WA2T/Hermes-Lite2/MicJackFixWires.jpeg

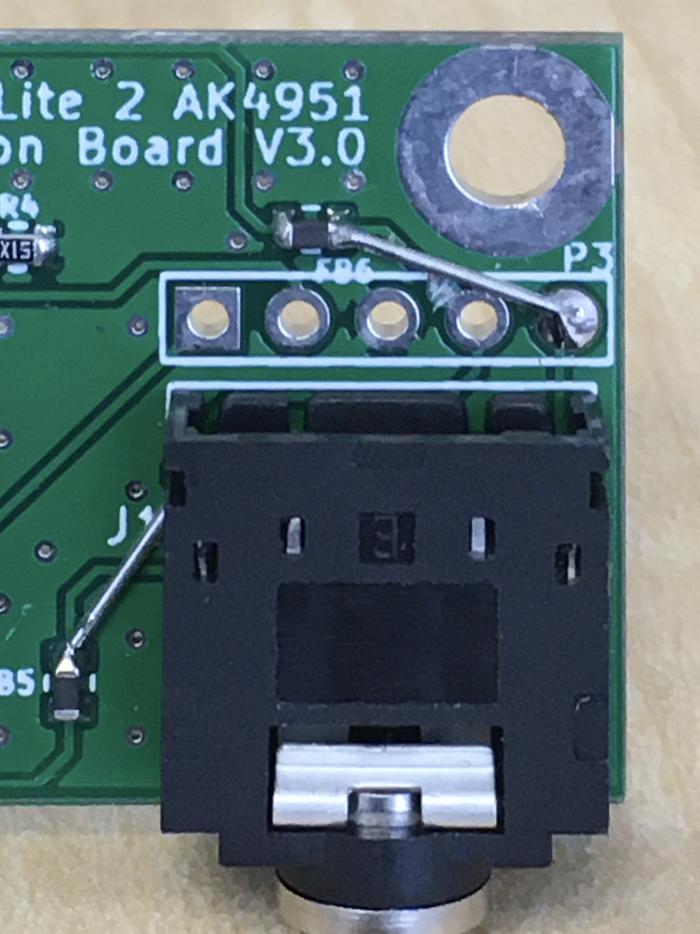
MicJackFixWires.jpeg
