WA2T/Hermes-Lite2/MicJackFixPCB.jpeg

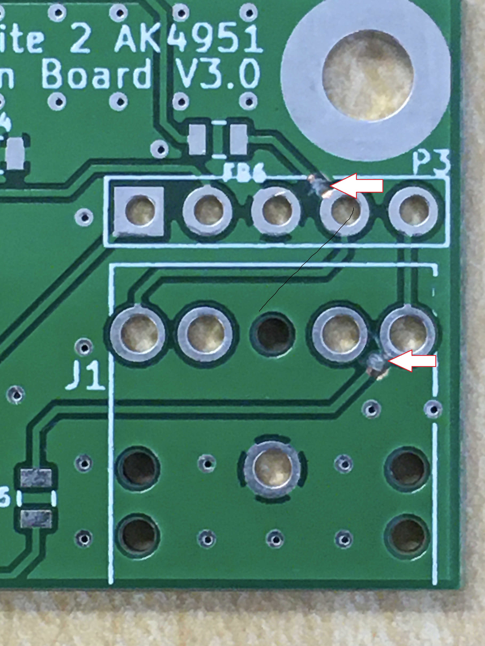
MicJackFixPCB.jpeg
