WA2T/Hermes-Lite2/CompBd1.jpeg

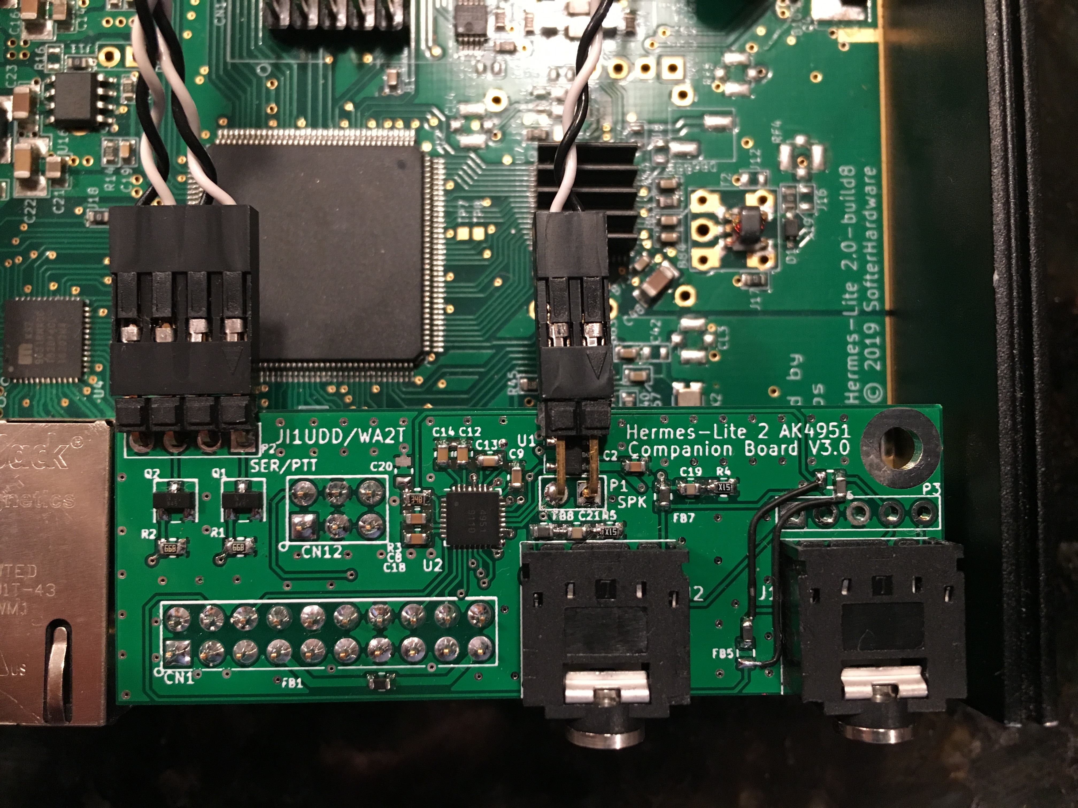
CompBd1.jpeg
