WA2T/Hermes-Lite2/CompBdMicJackMod.jpeg

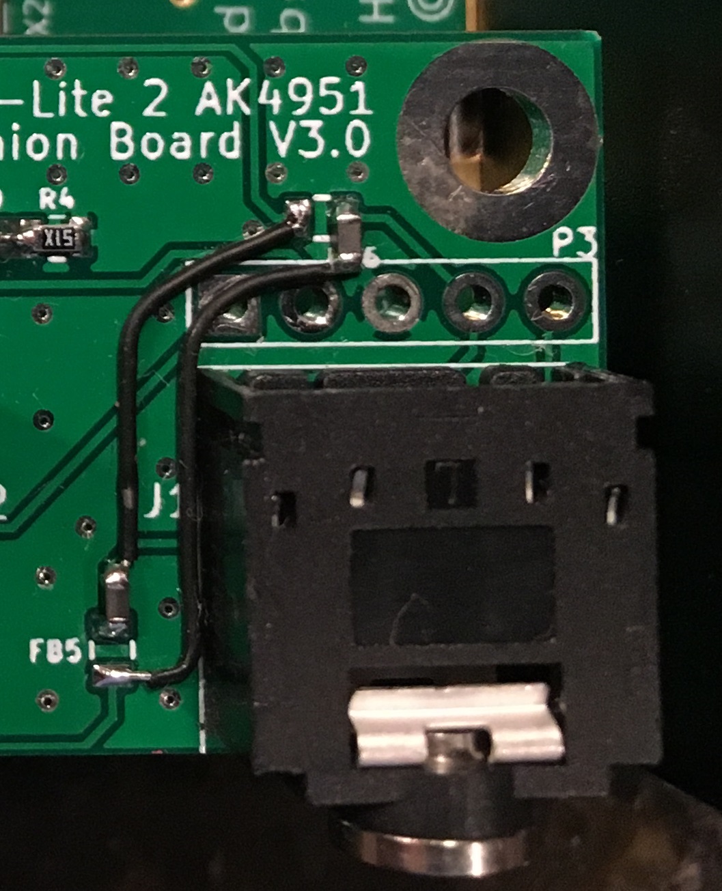
CompBdMicJackMod.jpeg
