WA2T/Hermes-Lite2/CompBoardV3Sch.jpg

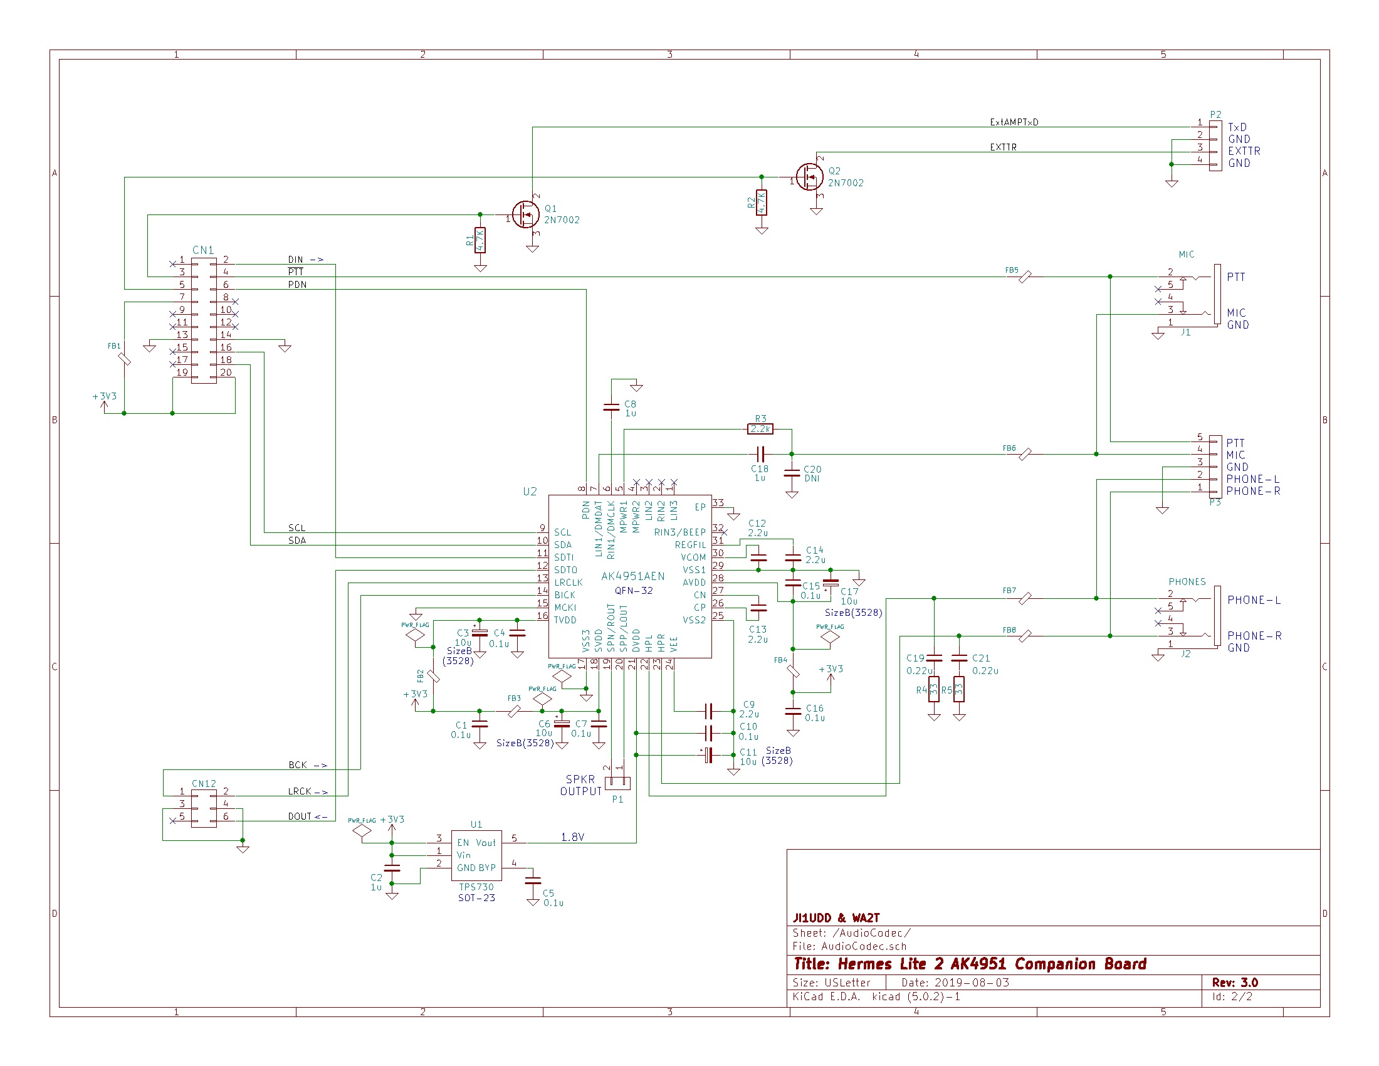
CompBoardV3Sch.jpg
