WA2T/Hermes-Lite2/HL2_Companion_V3.jpg

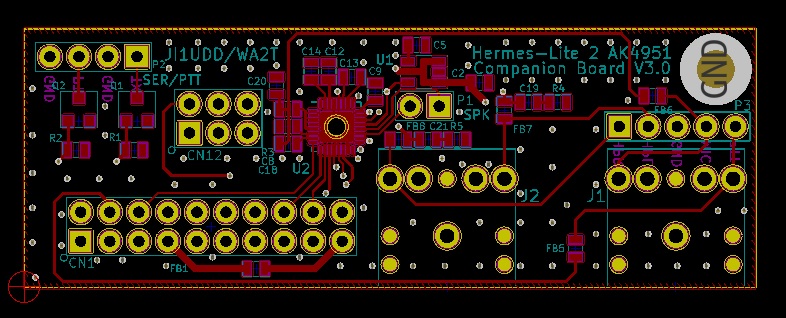
HL2_Companion_V3.jpg
