WA2T/Hermes-Lite2/PJ-307.jpg

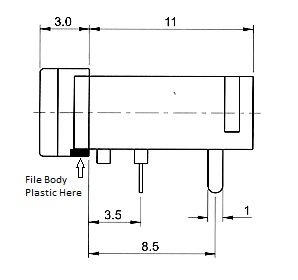
PJ-307.jpg
