WA2T/Hermes-Lite2/Digikey Cart.xlsx

Index | Quantity | Part Number | Manufacturer Part Number | Description | Customer Reference | Available | Backorder | Unit Price | Extended Price USD
1 | 3 | 1276-1102-1-ND | CL10A105KA8NNNC | CAP CER 1UF 25V X5R 0603 |  | 3 | 0 | 0.1 | 0.30
2 | 4 | 490-12738-1-ND | GRM188R61E225MA12D | CAP CER 2.2UF 25V X5R 0603 |  | 4 | 0 | 0.15 | 0.60
3 | 8 | 445-2205-1-ND | MPZ1608S601ATA00 | FERRITE BEAD 600 OHM 0603 1LN |  | 8 | 0 | 0.1 | 0.80
4 | 2 | T2N7002AKLMCT-ND | T2N7002AK,LM | MOSFET N-CH 60V 0.2A |  | 2 | 0 | 0.15 | 0.30
5 | 2 | 1292-1420-1-ND | 0603B224K250CT | CAP CER 0.22UF 25V X7R 0603 |  | 2 | 0 | 0.1 | 0.20
6 | 1 | 296-17577-1-ND | TPS73018DBVT | IC REG LINEAR 1.8V 200MA SOT23-5 |  | 1 | 0 | 0.82 | 0.82
7 | 1 | 974-1064-1-ND | AK4951EN | IC STEREO CODEC 24BIT 32QFN |  | 1 | 0 | 1.79 | 1.79
8 | 2 | CP1-3525N-ND | SJ1-3525N | CONN JACK STEREO 3.5MM R/A |  | 2 | 0 | 0.76 | 1.52
9 | 7 | 1276-CL10B104KB8NNNLCT-ND | CL10B104KB8NNNL | CAP CER 0.1UF 50V X7R 0603 |  | 7 | 0 | 0.1 | 0.70
10 | 2 | 311-4.7KGRCT-ND | RC0603JR-074K7L | RES SMD 4.7K OHM 5% 1/10W 0603 |  | 2 | 0 | 0.1 | 0.20
11 | 2 | 311-33.0HRCT-ND | RC0603FR-0733RL | RES SMD 33 OHM 1% 1/10W 0603 |  | 2 | 0 | 0.1 | 0.20
12 | 1 | 311-2.2KGRCT-ND | RC0603JR-072K2L | RES SMD 2.2K OHM 5% 1/10W 0603 |  | 1 | 0 | 0.1 | 0.10
13 | 4 | 1276-1853-1-ND | CL31F106ZPHNNNE | CAP CER 10UF 10V Y5V 1206 |  | 4 | 0 | 0.19 | 0.76
14 | 1 | S6106-ND | PPPC102LFBN-RC | CONN HDR 20POS 0.1 GOLD PCB |  | 1 | 0 | 1.26 | 1.26
15 | 1 | S7106-ND | PPPC032LFBN-RC | CONN HDR 6POS 0.1 GOLD PCB |  | 1 | 0 | 0.62 | 0.62
16 | 1 | 2057-PH2-20-UA-ND | PH2-20-UA | CONN HEADER VERT 20POS 2.54MM |  | 1 | 0 | 0.28 | 0.28
17 | 1 | 609-3234-ND | 67997-206HLF | CONN HEADER VERT 6POS 2.54MM |  | 1 | 0 | 0.32 | 0.32
18 | 1 | 2057-PH1RB-04-UA-ND | PH1RB-04-UA | CONN HEADER R/A 4POS 2.54MM |  | 1 | 0 | 0.15 | 0.15
19 | 1 | 2057-PH1RA-02-UA-ND | PH1RA-02-UA | CONN HEADER R/A 2POS 2.54MM |  | 1 | 0 | 0.1 | 0.10
