WA2T/Hermes-Lite2/hermeslite.kicad_pcb

## KiCad design hermeslite.kicad_pcb (2019-09-15)

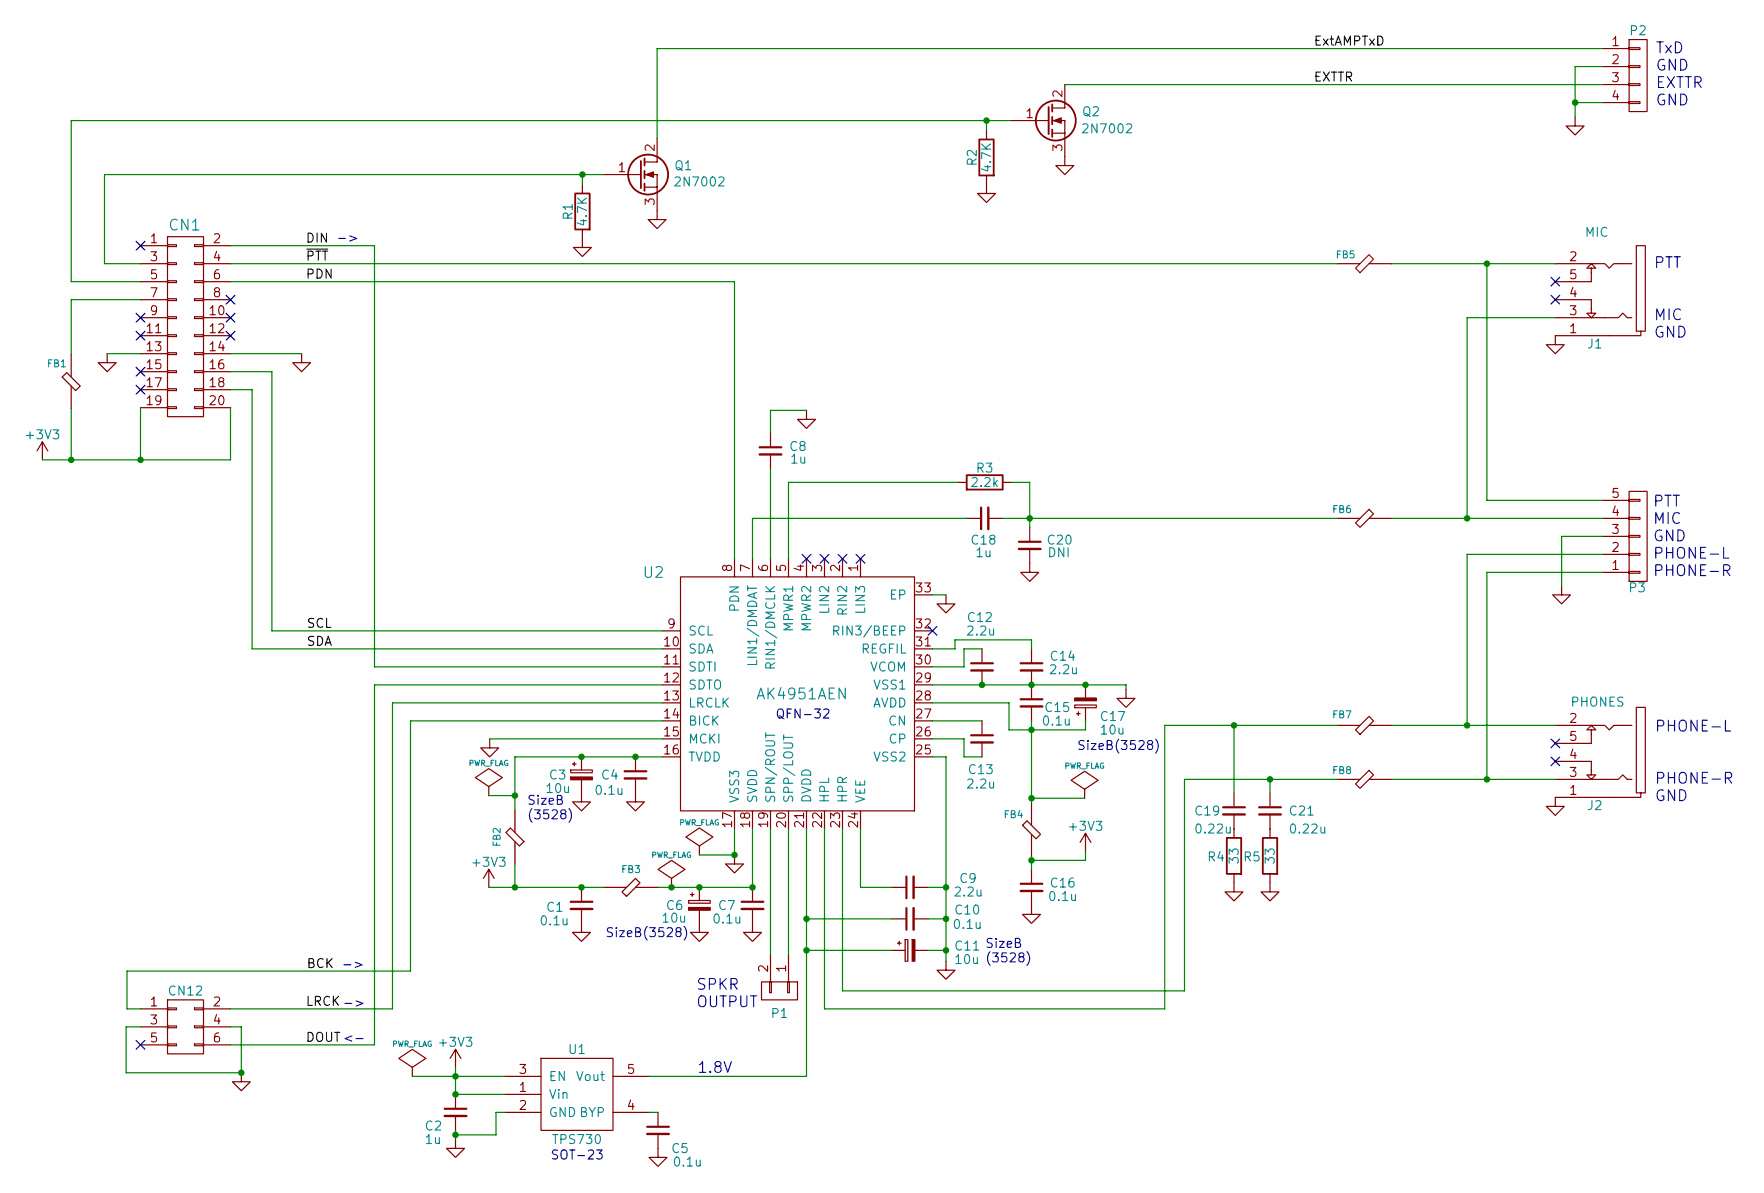
[picture p8: schematic AudioCodec.sch, Hermes Lite 2 AK4951 Companion Board]

Parts:
C1, C4, C5, C7, C10, C15, C16: 0.1u; SMD-0603
C2, C8, C18: 1u; SMD-0603
C3, C6, C11, C17: 10u; SMD-1206
C9, C12, C13, C14: 2.2u; SMD-0603
C19, C21: 0.22u; SMD-0603
C20: DNI; SMD-0603
CN1: IO20; 10x2
CN12: CONN_02X03; 3x2
FB1, FB2, FB3, FB4, FB5, FB6, FB7, FB8: FB; SMD-0603
J1: MIC; STEREO
J2: PHONES; STEREO
P1: CONN_01X02; 2x1
P2: CONN_01X04; 4x1
P3: CONN_01X05; 5x1
Q1, Q2: 2N7002; SOT23_2N7002
R1, R2: 4.7K; SMD-0603
R3: 2.2k; SMD-0603
R4, R5: 33; SMD-0603
U1: TPS730; SOT23
U2: AK4951AEN; QFN-32-1EP_4x4mm_Pitch0.4mm_Handsoldering

Connections:
+3V3: C1.1, C2.1, C16.1, CN1.19, CN1.20, FB1.1, FB2.2, FB3.2, FB4.1, U1.1 (Vin), U1.3 (EN)
/AudioCodec/BCK: CN12.1, U2.14 (BICK)
/AudioCodec/DIN: CN1.2, U2.11 (SDTI)
/AudioCodec/DOUT: CN12.6, U2.12 (SDTO)
/AudioCodec/EXTTR: P2.3, Q2.2 (D)
/AudioCodec/ExtAMPTxD: P2.1, Q1.2 (D)
/AudioCodec/LRCK: CN12.2, U2.13 (LRCLK)
/AudioCodec/PDN: CN1.6, U2.8 (PDN)
/AudioCodec/SCL: CN1.16, U2.9 (SCL)
/AudioCodec/SDA: CN1.18, U2.10 (SDA)
/AudioCodec/~PTT: CN1.4, FB5.2
GND: C1.2, C2.2, C3.2, C4.2, C5.2, C6.2, C7.2, C8.1, C9.2, C10.2, C11.2, C12.2, C14.2, C15.1, C16.2, C17.2, C20.2, CN1.13, CN1.14, CN12.3, CN12.4, J1.1, J2.1, P2.2, P2.4, P3.3, Q1.3 (S), Q2.3 (S), R1.2, R2.2, R4.2, R5.2, U1.2 (GND), U2.15 (MCKI), U2.17 (VSS3), U2.25 (VSS2), U2.29 (VSS1), U2.33 (EP)
unnamed: C3.1, C4.1, FB2.1, U2.16 (TVDD)
unnamed: C5.1, U1.4 (BYP)
unnamed: C6.1, C7.1, FB3.1, U2.18 (SVDD)
unnamed: C8.2, U2.6 (RIN1/DMCLK)
unnamed: C9.1, U2.24 (VEE)
unnamed: C10.1, C11.1, U1.5 (Vout), U2.21 (DVDD)
unnamed: C12.1, U2.30 (VCOM)
unnamed: C13.1, U2.27 (CN)
unnamed: C13.2, U2.26 (CP)
unnamed: C14.1, U2.31 (REGFIL)
unnamed: C15.2, C17.1, FB4.2, U2.28 (AVDD)
unnamed: C18.1, U2.7 (LIN1/DMDAT)
unnamed: C18.2, C20.1, FB6.1, R3.1
unnamed: C19.1, FB7.2, U2.22 (HPL)
unnamed: C19.2, R4.1
unnamed: C21.1, FB8.1, U2.23 (HPR)
unnamed: C21.2, R5.1
unnamed: CN1.3, Q1.1 (G), R1.1
unnamed: CN1.5, Q2.1 (G), R2.1
unnamed: CN1.7, FB1.2
unnamed: FB5.1, J1.2, P3.5
unnamed: FB6.2, J1.3, P3.4
unnamed: FB7.1, J2.2, P3.2
unnamed: FB8.2, J2.3, P3.1
unnamed: P1.1, U2.20 (SPP/LOUT)
unnamed: P1.2, U2.19 (SPN/ROUT)
unnamed: R3.2, U2.5 (MPWR1)

Notes on the sheet:
SPKR OUTPUT
PHONE-L PHONE-R GND
1.8V
PTT MIC GND PHONE-L PHONE-R
TxD GND EXTTR GND
SizeB (3528)
SizeB(3528)
SOT-23
QFN-32
PTT MIC GND

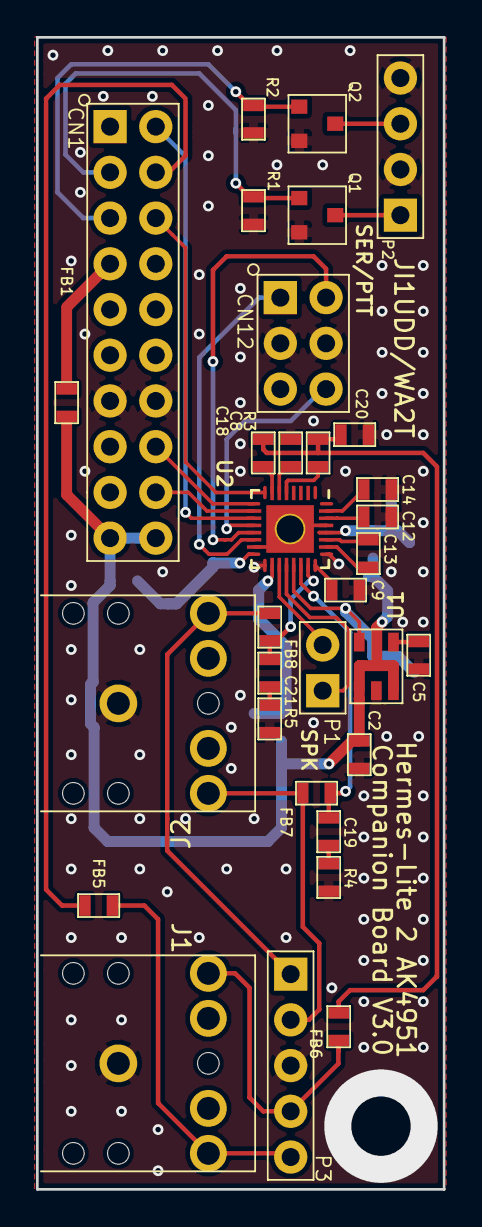
[picture p9: board hermeslite.kicad_pcb from above]

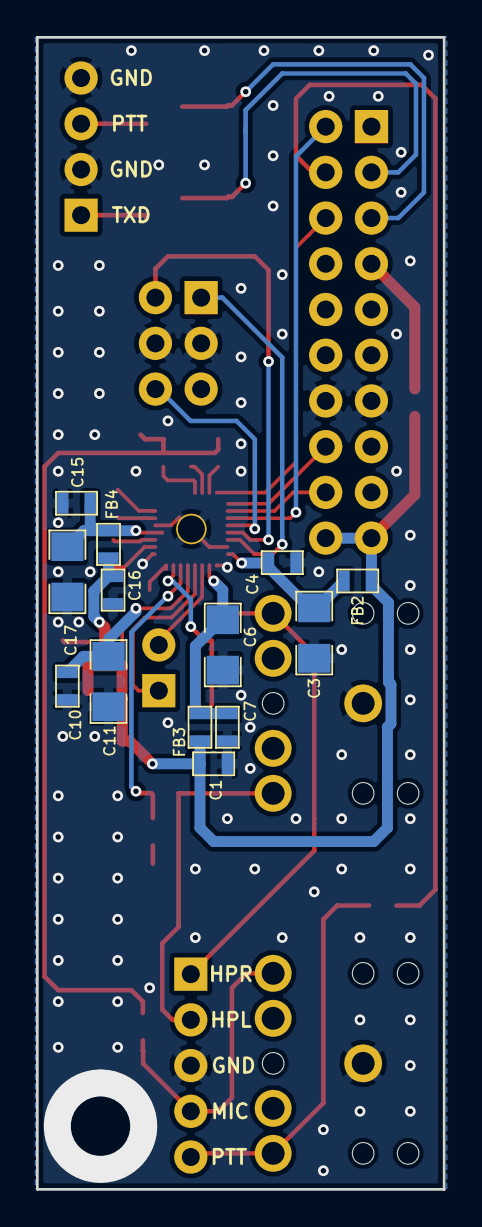
[picture p10: board hermeslite.kicad_pcb from below]

Board: 4 copper layers, 22.6 x 64.0 mm, 45 parts (13 on the bottom side), 39 nets.
